olgierd/ad8317_powermeter/(threads)

Thread 1 (2020-12-25):

Which hardware module to use?

fplanque, 2020-12-25:
This looks awesome!

The readme file says:

> Connect AD8317 module output to A0 pin of Arduino

Which AD8317 module are you using? Where can I get one?

Could you maybe post a photo of the whole system connected together?

Thank you.

whoim2, 2023-11-03:
https://sl.aliexpress.ru/p?key=v1sHUQv

Closed 2023-11-03.

Thread 2 (2023-04-04):

Problems with using

Tuburni, 2023-04-04:
Hello

I have a problem's
If I boot the Arduino in calibration mode (by shorting one of the buttons), and change the value of band_labels to 1G2 and press SAVE, then unplug the arduino from the power and turn it on in normal mode, for some reason the default value of 144 is displayed, and not in 1G2 which I chose
What is the problem?

olgierd, 2023-11-03:
Sorry, I'm unable to replicate it.

Closed 2023-11-03.

Thread 5 (2024-08-23):

Calibration and other things

andreasr81, 2024-08-23:
Hi, thanks for Sharing your project, i Build it and are Not able to mesure correct Output from my 5.8ghz vtx.

my question is: After the calibration, what should the Display Output? Do i have to mesure it without an rf Output connected?

secound question: you Write it has a headless mode, can you Tell me the Commands to use it that way?

Regards Andreas
