olgierd/ad8317_powermeter/(commit log)

2020-01-19 Add README, schematic + minor changes
2020-01-19 Add OLED info to assembly section in readme
2020-01-31 Allow using custom calibration points instead of -40;-10
2020-01-31 Add support of actual (physical) buttons
2020-06-05 Add calibration mode & saving cal to EEPROM
2020-06-05 Print CAL on display when no proper calibration found
2023-07-13 Add power display in mW and W
2023-11-24 Add option to load default calibration (via serial port). Original code by whoim2.
